UniOfGreenwich/MSA-Summer-School/src/ProjOverview/ProjOverview.md

# Project Overview: IOT DC Motor Predictive maintenance system

## System Requirements
A client has approached the university with the aim to develop an Internet of Things (IOT) DC Motor  Predictive maintenance system using the ESP8266 Lolin D1 mini pro WIFI enabled microcontroller.

The client has specified the following scope of functionality:

• Forward and reverse motor control
• Motor speed measurement
• Motor temperature measurement
• Ambient temperature and humidity measurement
• A simple internet interface control screen
• A Web based data logging system 
• 12V DC supply

The microcontroller and motor have been specified by the client the rest of the design and selection  of suitable components is down to you as the main contractor. The budget for the entire system is to be less than £20. The dimensions of the final system are to be no greater than 150 x 80 mm and should 
be fabricated on a single sided PCB. 

## Objectives
As the product designer it is your job to outline the objectives as to how you intend to meet the system  requirements. Objectives include what the system will look like, how it will be controlled, what sensors  will be used etc. The objectives must be agreed with the client before development progresses.

## Deliverables
A complete and fully functioning system meeting all of the system requirements. Comprehensive documentation and a technical report describing how the system works and a set of detailed test results. A Gantt chart and critical path analysis for project management purposes and reference
