UniOfGreenwich/MSA-Summer-School/src/SUMMARY.md

------------------------------------------------------
------------------------------------------------------
# Main
- [Introduction](Introduction/Introduction.md)
- [Self Study](SelfStudy/SelfStudy.md)
- [Project Overview](./ProjOverview/ProjOverview.md)
- [Project Management](./ProjMgmt/ProjMmgt.md)
- [Critcial Path](./CriticalPath/CriticalPath.md)
- [Documentation](Documentation/Documentation.md)
- [Circuit Design and Simulation](CDSim/CDSim.md) 
  - [OpAmps](CDSim/OpAmps.md) 
  - [MOSFETS](CDSim/MOSFETS.md)
  - [Filters](CDSim/Filters.md) 
- [Soldering Instructions](Soldering/Soldering_Instructions.md)
- [ESP8266](ESP8266/ESP8266.md)
    - [ESP8266](ESP8266/Set_Up.md)
    - [Testing Sensors](ESP8266/Testing_Sensors.md)
        - [Temperature](ESP8266/Temperature.md)
        - [Photo Interrupter](ESP8266/Photo_Interrupter.md)
        - [Accelerometer](ESP8266/Accelerometer.md)
    - [IoT Setup](ESP8266/IoT_Setup.md)
    - [Build Webpage](ESP8266/Build_WebPage.md)
    - [Upload and Running](ESP8266/Upload_Running.md)
- [Debian Rock C4](Debian_Rock/Debian_Rock.md)
     - [Internet](Debian_Rock/Internet.md)
     - [Updating Workbook](Debian_Rock/Workbook.md)
     - [IoT Network](Debian_Rock/IoT_Network.md)
     - [Python Script](Debian_Rock/Python_Script.md)
     - [WireShark](Debian_Rock/WireShark.md)
- [Security IoT](Security_IoT/Security_IoT.md)
  - [Case Study](Security_IoT/Case_Study.md)
- [Data Analysis](Data_Analysis/Data_Analysis.md)
