UniOfGreenwich/MSA-Summer-School/src/CDSim/CDSim.md

# Circuit Design and Simulation

In this section here on using Proteus a circuit design and simulation tool.

You can download these [Proteus Files](./Proteus_Files.zip) that contain the following: 
    
- lm2917.pdsprj
- opamp_example.pdsprj
- Parts List.docx
- Proteus Tutorial.pdf
- Scale and Offset.pdsprj
- smooth filter.txt
- tmp36_example.pdsprj

>SHA256Sum:
>> - Proteus_Files.zip 
>>      - 1c244285206f9be255be8364535bcc055f682732a735297953e244dbe85662f7 

## Proteus Introduction

This [link](https://gre.cloud.panopto.eu/Panopto/Pages/Viewer.aspx?id=464b3dd4-3045-4b1b-89d8-b1d0007ff368) provides a guided walkthrough on Proteus 

## Critical Path Example

Here is an external video on how to make a critical path in Proteus -> [https://youtu.be/oP9RiG7vSrk](https://youtu.be/oP9RiG7vSrk)

## Making a Footprint

Here is an external video on how to make Footprint path in Proteus -> [https://www.youtube.com/watch?v=dU53Pvil-Bs](https://www.youtube.com/watch?v=dU53Pvil-Bs)

## Circuit Test

You can find the proteus schematic here [virtual terminal_1](./virtual%20terminal_1.pdsprj): 

>SHA256Sum:
>> - virtual terminal_1.pdsprj
>>      - 572d9c8b4a52e9e021e5dfe4659d0e0cf61f7ebcaf3cc9e2ffdf41c74fcef2c3

## Final Design 

You can download the final design for the [Predicitive Maintenance board here](./Schematics_Final_PM_design.zip) when instructed to do so, it contains the following:

 - jack_plug.pdsprj 
 - Parts List.docx
 - Predictive_pcb.pdsprj

>SHA256Sum:
>> - Schematics_Final_PM_design.zip
>>      - 46d65c8eacd6d50e1dcc51abc4547fe835d745e94346c75f1026c759ac2b4b6f
