UniOfGreenwich/MSA-Summer-School/src/Documentation/Documentation.md

# Documentation

In this section you can find a list with links to documentation for all components used in this project, once clicked the document downloads if access over the internet, else, if run locally, the files are opened. 

- Low Power FET-Input Op Amp: [AD822.pdf](../Data_Sheets/AD822.pdf)
 
- Lolin D1 Espressif System SoC \\(\mu\\)Controller: [ESP8266.pdf](../Data_Sheets/ESP8266.pdf)

- DHT11: [humidity_sensor.pdf](../Data_Sheets/humidity_sensor.pdf)

- Photo-Interrupter: [ktir0611s.pdf](../Data_Sheets/ktir0611s.pdf)

- Frequency to Voltage Converter: [lm2917-n.pdf](../Data_Sheets/lm2917-n.pdf)

- \\(\mu\\)A7800 Series Positive-Voltage Regulator: [LM7805.pdf](../Data_Sheets/LM7805.pdf)

- Precision Op Amp: [LT1013-LT1014.pdf](../Data_Sheets/LT1013-LT1014.pdf)

- Op Amp: [LT1495_OPAMP.pdf](../Data_Sheets/LT1495_OPAMP.pdf)

- 2.7V to 6.0V Single Supply CMOS Op Amp: [MCP601.pdf](../Data_Sheets/MCP601.pdf)

- 50 \\(\mu\\)A, 550 kHz Rail-to-Rail Op Amp:
[MCP6242.pdf](../Data_Sheets/MCP6242.pdf)

- Accelerometer: [MMA85451Q.pdf](../Data_Sheets/MMA8451Q.pdf)

- Single 8-Channel Analog Multiplexer: [MUX_4051B.pdf](../Data_Sheets/MUX_4051B.pdf)

- Singleboard Computer: [Rock C+4](../Data_Sheets/Rock.pdf)

- 5-A H-Bridge: [tle_5206_motor_drive.pdf](../Data_Sheets/tle_5206_motor_drive.pdf)

- Low Voltage Temperature Sensor: [TMP35_36_37.pdf](../Data_Sheets/TMP35_36_37.pdf)
