UniOfGreenwich/MSA-Summer-School/src/ESP8266/ESP8266.md

# ESP8266
We are now going to get familiar with the ESP8266 and subsequent PCB.

The following sections should be followed in order:

- [ESP8266 Setup](./Set_Up.md.md)

- [Testing](./Testing_Sensors.md)

    - [Temperature](./Temperature.md)
    - [Photo Interrupter](./Photo_Interrupter.md)
    - [Accelerometer](./Accelerometer.md)

- [Build Webpage](./Build_WebPage.md)

- [IoT Setup](./IoT_Setup.md)

- [KTIR0611s - Photo-Interrupter (Motor Speed)](./Photo_Interrupter.md)
