UniOfGreenwich/MSA-Summer-School/src/Debian_Rock/WireShark.md

# Wireshark

Looking at the packets coming over...

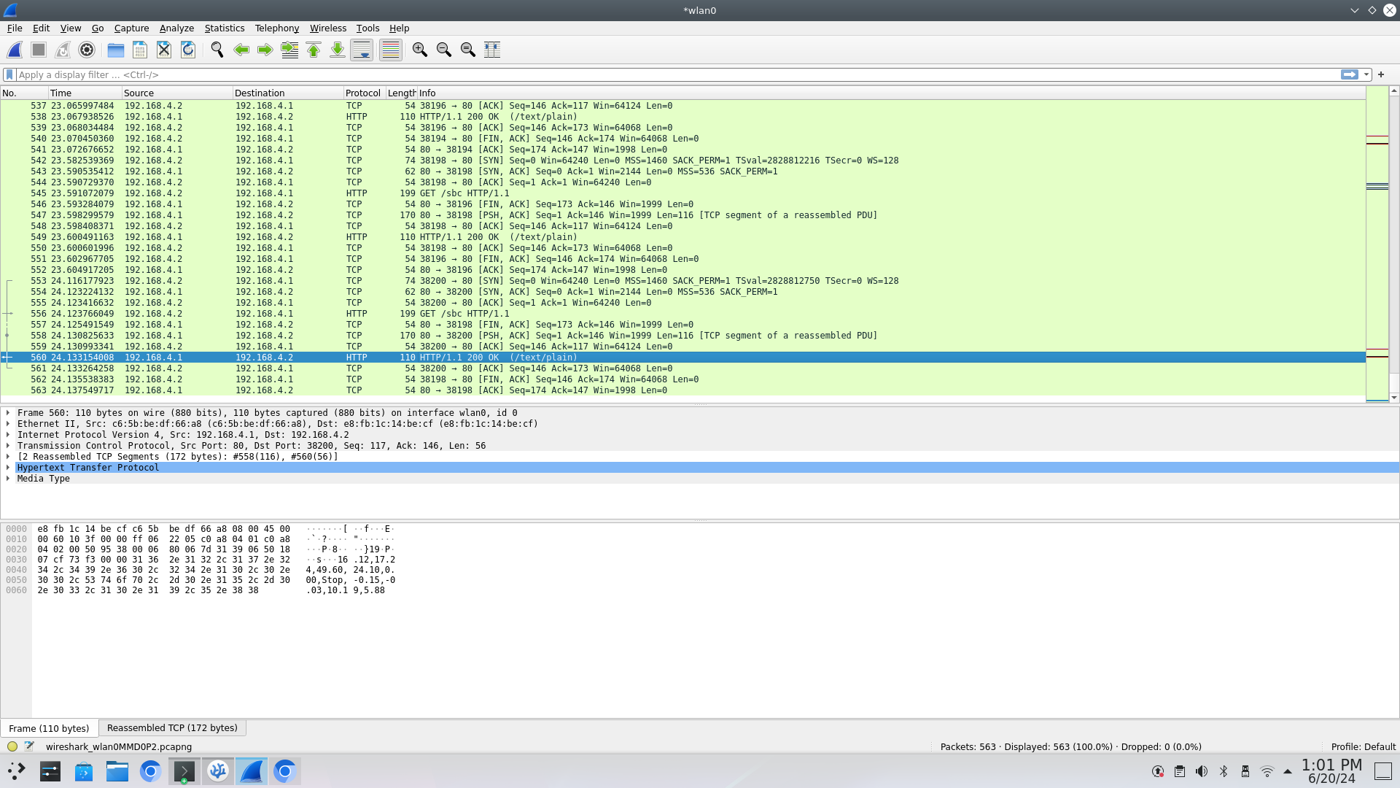
[picture p27: src/Debian_Rock/figures/wireshark_out.png]
