UniOfGreenwich/MSA-Summer-School/src/Data_Analysis/figures/seaborn.png

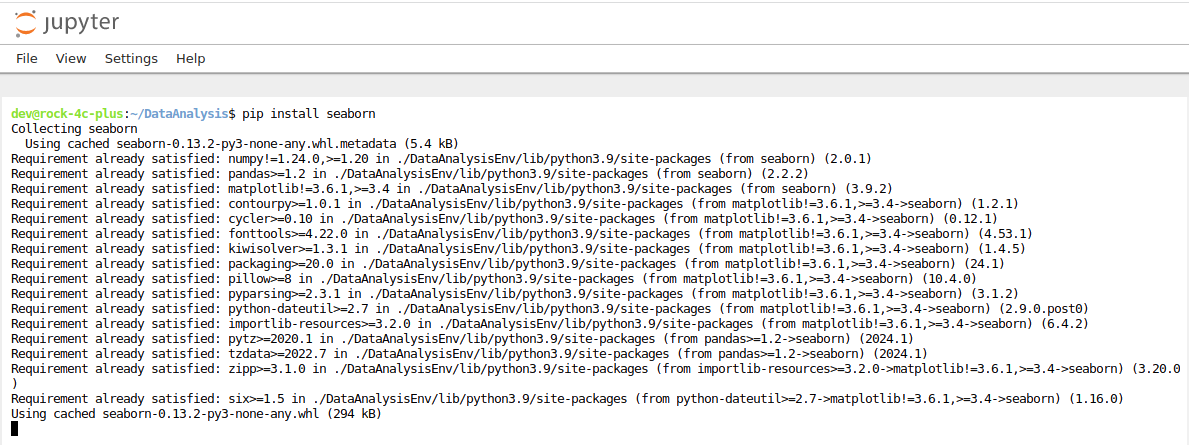
src/Data_Analysis/figures/seaborn.png
