UniOfGreenwich/MSA-Summer-School/src/Data_Analysis/figures/termina.png

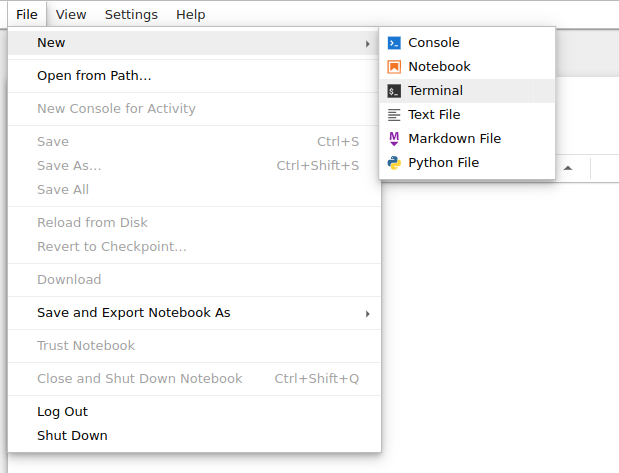
src/Data_Analysis/figures/termina.png
