UniOfGreenwich/MSA-Summer-School/src/Debian_Rock/figures/wifi_scan.png

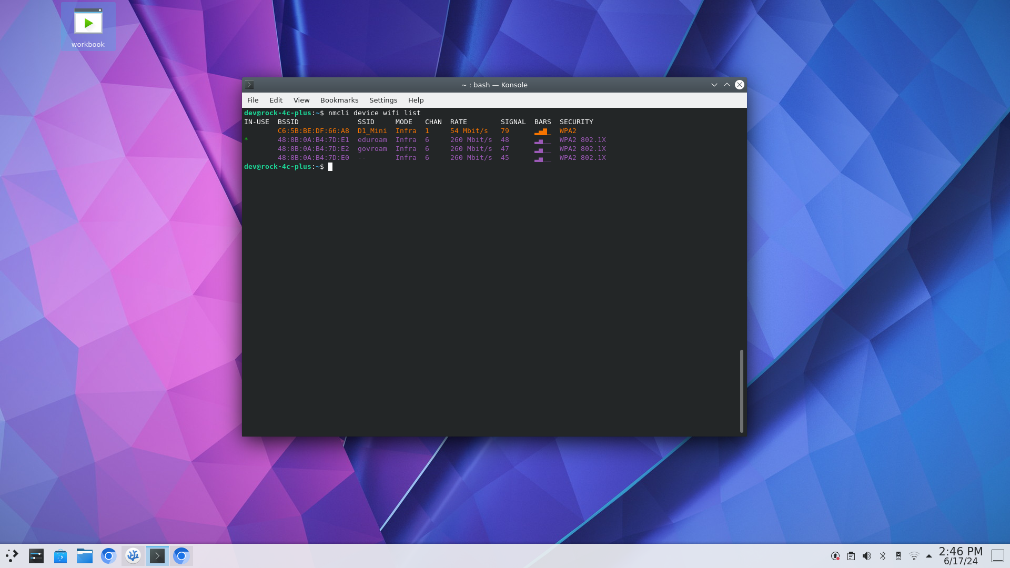
src/Debian_Rock/figures/wifi_scan.png
