UniOfGreenwich/MSA-Summer-School/src/ESP8266/Testing_Sensors.md

# Testing Sensors

Now that you have constructed solderd the board we need to test the sensing components individually. 

It is best practice to test componments individually to ensure that each one works as intended, and that we can fix any issues that arrive through troubleshooting one thing at a time, instead having to shift through many problems. 

We can test in the components in combinations afterwards if needed. This is more cost effective than running all tests at the same time at the beginning:

- [TMP36 - Ambient Temperature && Motor Tempeature && DH11 Temperature](./Temperature.md)

- [DHT22 - Humidity](./DHT22_Humidity.md)

- [MMA85451Q - Accelerometer](./Accelerometer.md)

- [KTIR0611s - Photo-Interrupter (Motor Speed)](./Photo_Interrupter.md)
