UniOfGreenwich/MSA-Summer-School/(list of files, drawings)

Other design files:
src/CDSim/virtual terminal_1.pdsprj
