UniOfGreenwich/MSA-Summer-School/(commit log)

2024-06-17 add: Wireshark page
2024-06-17 mod: wireshark index added
2024-06-17 fix: fix wireshark path
2024-06-19 add/mod: new scripts for testing, new guides, some typo fixing
    [Accelerometer.ino, MotorSpeed.ino, Temperature.ino]
2024-06-19 fix: wrong QR code
    [Predictive.ino]
2024-06-20 add/mod: new images and data file
    [data.csv]
2024-08-06 mod: updated more content
    [data.csv]
2024-08-16 add: sample data from artefact
    [data.csv]
2024-08-18 add: proteus and circuit stuff
2024-08-20 add: new circuit#
    [virtual terminal_1.pdsprj]
